walczakkamil/lora_aprs_repeater/img/20260804_183627.jpg

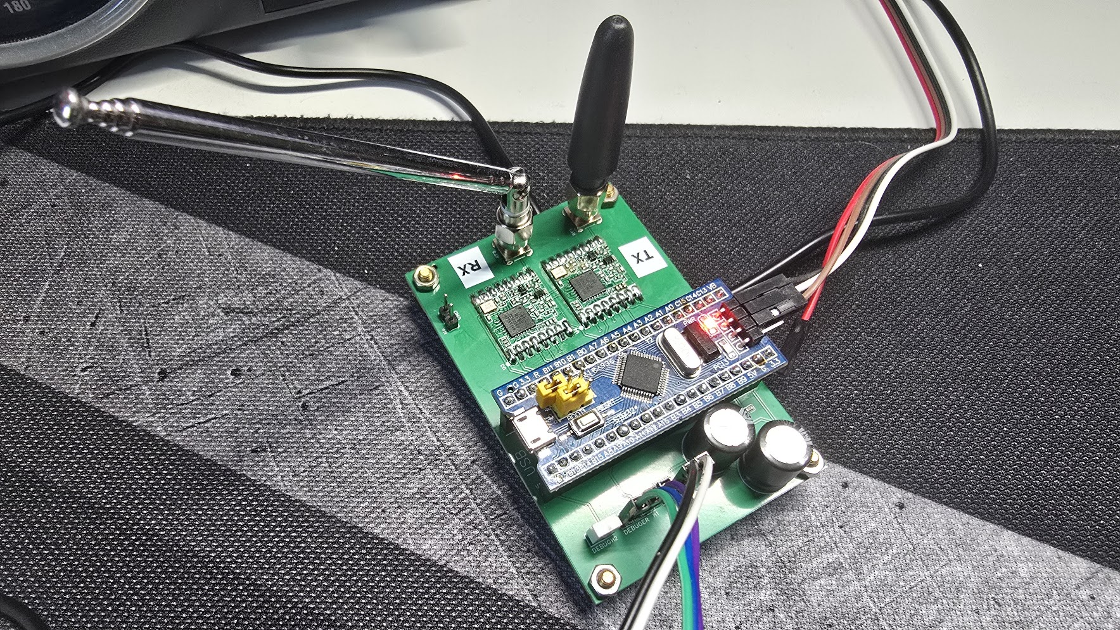
img/20260804_183627.jpg
