walczakkamil/lora_aprs_repeater/(list of files, drawings)

Other design files:
PCB/repeater.eprj
PCB/repeater_v2.eprj
