walczakkamil/lora_aprs_repeater/STM32/Core/Src/main.c

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
/* Includes ------------------------------------------------------------------*/
#include "main.h"

/* USER CODE BEGIN Includes */
#include <stdio.h>
#include <string.h>
#include <stdarg.h>
#include <stdint.h>
/* USER CODE END Includes */

ADC_HandleTypeDef hadc1;

IWDG_HandleTypeDef hiwdg;

RTC_HandleTypeDef hrtc;

SPI_HandleTypeDef hspi1;

UART_HandleTypeDef huart1;

/* USER CODE BEGIN PV */
// --- Hardware configuration ---
// RX Module (RFM96) - SPI1
#define RX_CS_PORT    GPIOA
#define RX_CS_PIN     GPIO_PIN_4
#define RX_RST_PORT   GPIOB
#define RX_RST_PIN    GPIO_PIN_0

// TX Module (RFM96) - SPI1
#define TX_CS_PORT    GPIOA
#define TX_CS_PIN     GPIO_PIN_3
#define TX_RST_PORT   GPIOB
#define TX_RST_PIN    GPIO_PIN_10

// Debug & LED
#define DEBUG_PIN_PORT GPIOB
#define DEBUG_PIN      GPIO_PIN_12
#define LED_PORT       GPIOC
#define LED_PIN        GPIO_PIN_13

// --- LORA Parameters---
#define LORA_RX_FREQ    434855000
#define LORA_TX_FREQ    434955000

#define LORA_RX_SF      9
#define LORA_RX_BW_IDX  7         		// 125 kHz (7 = 125 kHz)
#define LORA_RX_CR      3         		// 4/7
#define LORA_RX_POWER   17        		// Full power (17 dBm)
//#define LORA_RX_POWER   20       		// +20 dBm (100 mW) - High Power PA_DAC

#define LORA_TX_SF      9
#define LORA_TX_BW_IDX  7         		// 125 kHz (7 = 125 kHz)
#define LORA_TX_CR      3         		// 4/7
#define LORA_TX_POWER   10        		// ~50% of power (~10 dBm)

#define TELEMETRY_INTERVAL 3600000 		// 1h
#define APRS_CALLSIGN   "SP7FM-1"
#define APRS_COORDS     "!5144.22N/01934.44E"

// --- SYSTEM ---
#define QUEUE_SIZE 5
#define MAX_PKT_LEN 256

typedef struct {
    uint8_t data[MAX_PKT_LEN];
    uint8_t len;
    uint8_t tx_counter;
} LoRaPacket;

uint16_t tx_reset_counter = 0;
uint32_t lastRebootTick = 0; 	// last restart/start time
uint8_t reset_time = 6;     	// how often reboot, in h

LoRaPacket txQueue[QUEUE_SIZE];
uint8_t queueHead = 0;
uint8_t queueTail = 0;

uint32_t lastTelemetryTime = 0;
volatile uint8_t packetReceivedFlag = 0;
volatile uint8_t txPacketReceivedFlag = 0;

typedef struct {
    GPIO_TypeDef* CS_Port;
    uint16_t      CS_Pin;
    GPIO_TypeDef* RST_Port;
    uint16_t      RST_Pin;
    uint32_t      Frequency;
    uint8_t       SpreadingFactor;
    uint8_t       BandwidthIdx;
    uint8_t       CodingRate;
    uint8_t       Power;
} LoRa_Module;

LoRa_Module loraRX = { RX_CS_PORT, RX_CS_PIN, RX_RST_PORT, RX_RST_PIN, LORA_RX_FREQ, LORA_RX_SF, LORA_RX_BW_IDX, LORA_RX_CR, LORA_RX_POWER };
LoRa_Module loraTX = { TX_CS_PORT, TX_CS_PIN, TX_RST_PORT, TX_RST_PIN, LORA_TX_FREQ, LORA_TX_SF, LORA_TX_BW_IDX, LORA_TX_CR, LORA_TX_POWER };

/* USER CODE END PV */

void SystemClock_Config(void);
static void MX_GPIO_Init(void);
static void MX_SPI1_Init(void);
static void MX_USART1_UART_Init(void);
static void MX_ADC1_Init(void);
static void MX_IWDG_Init(void);
static void MX_RTC_Init(void);
/* USER CODE BEGIN PFP */
void LoRa_Init(LoRa_Module* mod);
void LoRa_SetMode(LoRa_Module* mod, uint8_t mode);
uint8_t LoRa_Send(LoRa_Module* mod, uint8_t* data, uint8_t len);
uint8_t LoRa_Receive(LoRa_Module* mod, uint8_t* buffer);
void Queue_Push(uint8_t* data, uint8_t len, uint8_t tx_counter);
int Queue_Pop(uint8_t* buffer, uint8_t* out_tx_counter);
void SendTelemetry(void);
void DebugPrint(const char *format, ...);
float GetInternalVoltage(void);
/* USER CODE END PFP */

/* USER CODE BEGIN 0 */

// SX1278 registry
#define REG_FIFO 0x00
#define REG_OP_MODE 0x01
#define REG_FRF_MSB 0x06
#define REG_FRF_MID 0x07
#define REG_FRF_LSB 0x08
#define REG_PA_CONFIG 0x09
#define REG_LNA 0x0C
#define REG_FIFO_ADDR_PTR 0x0D
#define REG_FIFO_TX_BASE_ADDR 0x0E
#define REG_FIFO_RX_BASE_ADDR 0x0F
#define REG_FIFO_RX_CURRENT_ADDR 0x10
#define REG_IRQ_FLAGS 0x12
#define REG_RX_NB_BYTES 0x13
#define REG_MODEM_CONFIG_1 0x1D
#define REG_MODEM_CONFIG_2 0x1E
#define REG_DIO_MAPPING_1 0x40

// Operating mode
#define MODE_LONG_RANGE_MODE 0x80
#define MODE_SLEEP 0x00
#define MODE_STDBY 0x01
#define MODE_TX 0x03
#define MODE_RX_CONTINUOUS 0x05

uint8_t LoRa_ReadReg(LoRa_Module* mod, uint8_t addr) {
    uint8_t txByte = addr & 0x7F;
    uint8_t rxByte = 0;
    HAL_GPIO_WritePin(mod->CS_Port, mod->CS_Pin, GPIO_PIN_RESET);
    HAL_SPI_Transmit(&hspi1, &txByte, 1, 100);
    HAL_SPI_Receive(&hspi1, &rxByte, 1, 100);
    HAL_GPIO_WritePin(mod->CS_Port, mod->CS_Pin, GPIO_PIN_SET);
    return rxByte;
}

void LoRa_WriteReg(LoRa_Module* mod, uint8_t addr, uint8_t val) {
    uint8_t data[2] = { addr | 0x80, val };
    HAL_GPIO_WritePin(mod->CS_Port, mod->CS_Pin, GPIO_PIN_RESET);
    HAL_SPI_Transmit(&hspi1, data, 2, 100);
    HAL_GPIO_WritePin(mod->CS_Port, mod->CS_Pin, GPIO_PIN_SET);
}

void LoRa_Init(LoRa_Module* mod) {
    // 0. Check if CS is high before start
    HAL_GPIO_WritePin(mod->CS_Port, mod->CS_Pin, GPIO_PIN_SET);

    // 1. Hardware Reset
    HAL_GPIO_WritePin(mod->RST_Port, mod->RST_Pin, GPIO_PIN_RESET);
    HAL_Delay(15);
    HAL_GPIO_WritePin(mod->RST_Port, mod->RST_Pin, GPIO_PIN_SET);
    HAL_Delay(15);

    // 2. Sleep mode, enable LongRangeMode registry
    LoRa_SetMode(mod, MODE_SLEEP);
    LoRa_WriteReg(mod, REG_OP_MODE, MODE_LONG_RANGE_MODE | MODE_SLEEP);
    HAL_Delay(5);

    // 3. frequency configuration (FRF)
    uint64_t frf = ((uint64_t)mod->Frequency << 19) / 32000000;
    LoRa_WriteReg(mod, REG_FRF_MSB, (uint8_t)(frf >> 16));
    LoRa_WriteReg(mod, REG_FRF_MID, (uint8_t)(frf >> 8));
    LoRa_WriteReg(mod, REG_FRF_LSB, (uint8_t)(frf >> 0));

    // 4. Modem config (BW, CR, SF)
    uint8_t config1 = (mod->BandwidthIdx << 4) | (mod->CodingRate << 1);
    LoRa_WriteReg(mod, REG_MODEM_CONFIG_1, config1);

    // SF, CRC ON (0x04)
    LoRa_WriteReg(mod, REG_MODEM_CONFIG_2, (mod->SpreadingFactor << 4) | 0x04);

    // 5.Power and gain config (LNA)
    // Set LNA Gain (Max gain, Boost on) and PA_CONFIG i OCP for both modules,
    // to enable 2-way communication (RX and TX).
    LoRa_WriteReg(mod, REG_LNA, 0x23);
    if (mod->Power >= 20) {
        // High Power +20 dBm (100 mW)
        LoRa_WriteReg(mod, 0x0B, 0x3B);          // OCP set to 150 mA (wymagane przy +20 dBm)
        LoRa_WriteReg(mod, 0x4D, 0x87);          // RegPaDac: Enable +20 dBm mode
        LoRa_WriteReg(mod, REG_PA_CONFIG, 0x8F); // PA_BOOST pin, max output power (15 + 5 dBm = 20 dBm)
    } else {
        // Standard mode (+2 dBm to +17 dBm)
        LoRa_WriteReg(mod, 0x0B, 0x2B);          // OCP set to 100 mA
        LoRa_WriteReg(mod, 0x4D, 0x84);          // RegPaDac: Normal/Default mode

        uint8_t paPower = (mod->Power < 2) ? 0 : (mod->Power - 2);
        LoRa_WriteReg(mod, REG_PA_CONFIG, 0x80 | paPower);
    }

    // 6. FIFO config
    LoRa_WriteReg(mod, REG_FIFO_TX_BASE_ADDR, 0);
    LoRa_WriteReg(mod, REG_FIFO_RX_BASE_ADDR, 0);

    // 7. Standby mode
    LoRa_SetMode(mod, MODE_STDBY);
    HAL_Delay(5);

    uint8_t ver = LoRa_ReadReg(mod, 0x42);
    DebugPrint("LORA: Init CS Pin %d (Ver: 0x%02X)\r\n", mod->CS_Pin, ver);
}

void LoRa_SetMode(LoRa_Module* mod, uint8_t mode) {
    LoRa_WriteReg(mod, REG_OP_MODE, MODE_LONG_RANGE_MODE | mode);
}

uint8_t LoRa_Send(LoRa_Module* mod, uint8_t* data, uint8_t len) {
    // 1. Wake radio from SLEEP to STDBY
    LoRa_SetMode(mod, MODE_STDBY);

    // !!! IMPORTANT: We allow time for the oscillator to stabilize (Warm-up).
    // Without this, writing to the FIFO may fail immediately after waking up.
    HAL_Delay(2);

    // 2. fill the buffer
    LoRa_WriteReg(mod, REG_FIFO_ADDR_PTR, 0);
    for(int i=0; i<len; i++) {
        LoRa_WriteReg(mod, REG_FIFO, data[i]);
    }

    // 3. start transmitting
    LoRa_WriteReg(mod, 0x22, len);
    LoRa_SetMode(mod, MODE_TX);

    // 4. Wait for TX finish
    uint32_t start = HAL_GetTick();
    uint8_t tx_success = 0;

    while(HAL_GetTick() - start < 2000) { // Timeout 2 sec.
    	if(LoRa_ReadReg(mod, REG_IRQ_FLAGS) & 0x08) {
    		tx_success = 1; // TxDone!
    		break;
		}
	}

    // 5. Clear flags
    LoRa_WriteReg(mod, REG_IRQ_FLAGS, 0xFF);

    // 6. Change mode STDBY to SLEEP, energy savings
    LoRa_SetMode(mod, MODE_SLEEP);

    return tx_success;
}

uint8_t LoRa_Receive(LoRa_Module* mod, uint8_t* buffer) {
    uint8_t irq = LoRa_ReadReg(mod, REG_IRQ_FLAGS);
    if(irq & 0x40) { // RxDone
        uint8_t len = 0;
        if(!(irq & 0x20)) { // CRC OK
            len = LoRa_ReadReg(mod, REG_RX_NB_BYTES);
            uint8_t currentAddr = LoRa_ReadReg(mod, REG_FIFO_RX_CURRENT_ADDR);
            LoRa_WriteReg(mod, REG_FIFO_ADDR_PTR, currentAddr);
            for(int i=0; i<len; i++) {
                buffer[i] = LoRa_ReadReg(mod, REG_FIFO);
            }
        }
        LoRa_WriteReg(mod, REG_IRQ_FLAGS, 0xFF);
        return len;
    }
    return 0;
}

void DebugPrint(const char *format, ...) {
    // Debug mode, PB12
    if(HAL_GPIO_ReadPin(DEBUG_PIN_PORT, DEBUG_PIN) == GPIO_PIN_RESET) {
        char buffer[128];
        va_list args;
        va_start(args, format);
        vsnprintf(buffer, sizeof(buffer), format, args);
        va_end(args);
        HAL_UART_Transmit(&huart1, (uint8_t*)buffer, strlen(buffer), 100);
    }
}

void Queue_Push(uint8_t* data, uint8_t len, uint8_t tx_counter) {
    uint8_t nextHead = (queueHead + 1) % QUEUE_SIZE;
    if(nextHead != queueTail) {
        memcpy(txQueue[queueHead].data, data, len);
        txQueue[queueHead].len = len;
        txQueue[queueHead].tx_counter = tx_counter;
        queueHead = nextHead;
        DebugPrint("QUEUE: Package added (%d B)\r\n", len);
    } else {
        DebugPrint("QUEUE: FULL!\r\n");
    }
}

int Queue_Pop(uint8_t* buffer, uint8_t* out_tx_counter) {
    if(queueHead == queueTail) return 0;

    int len = txQueue[queueTail].len;
    memcpy(buffer, txQueue[queueTail].data, len);

    if(out_tx_counter != NULL) {
        *out_tx_counter = txQueue[queueTail].tx_counter;
    }

    queueTail = (queueTail + 1) % QUEUE_SIZE;
    return len;
}

float GetInternalVoltage(void) {
    HAL_ADC_Start(&hadc1);
    if (HAL_ADC_PollForConversion(&hadc1, 100) == HAL_OK) {
        uint32_t adcVal = HAL_ADC_GetValue(&hadc1);
        if(adcVal == 0) return 0.0;
        // VREFINT usually is 1.20V
        return (1.20f * 4095.0f) / (float)adcVal;
    }
    return 0.0;
}

void SendTelemetry(void) {
    char packet[200];
    float voltage = GetInternalVoltage();

    // LoRa APRS frame format:
    // 1. Head LoRa: < (0x3C), 0xFF, 0x01
    // 2. Head AX.25: Źródło>Cel,Ścieżka:
    // 3. APRS Data: !Lat/Lon#Comment
    // 4. TX reset counter
    sprintf(packet, "\x3c\xff\x01%s>APRS,WIDE1-1:%s#%s BAT:%.2fV R_CNT:%u", APRS_CALLSIGN, APRS_COORDS, APRS_CALLSIGN, voltage, tx_reset_counter);

    DebugPrint("TELEMETRY: %s\r\n", packet + 3); // +3 for better output codding
    Queue_Push((uint8_t*)packet, strlen(packet), 1);
}

// Interruption EXTI (RX DIO0 - PB1 and TX DIO0 - PB11)
void HAL_GPIO_EXTI_Callback(uint16_t GPIO_Pin) {
    if(GPIO_Pin == LORA_DIO0_Pin) {
        packetReceivedFlag = 1;
    } else if(GPIO_Pin == TX_DIO0_Pin) {
        txPacketReceivedFlag = 1;
    }
}

// Check if radio is alvie
uint8_t LoRa_IsAlive(LoRa_Module* mod) {
    // Testing version registry, expected value 0x12 for SX127x
    uint8_t version = LoRa_ReadReg(mod, 0x42);
    uint8_t mode = LoRa_ReadReg(mod, 0x01);

    if (version == 0x12 && mode != 0xFF) {
        return 1; // Radio is alive
    }
    return 0; // Radio not responding or SPI bus hang
}

void Update_Reset_Counter(void) {
    // 1. PWR and registry BKP up
    __HAL_RCC_PWR_CLK_ENABLE();
    __HAL_RCC_BKP_CLK_ENABLE();
    HAL_PWR_EnableBkUpAccess();

    // 2. Read 1st registry
    tx_reset_counter = HAL_RTCEx_BKUPRead(&hrtc, RTC_BKP_DR1);

    // 3. If reset by Watchdoga (IWDG), increment counter
    if (__HAL_RCC_GET_FLAG(RCC_FLAG_IWDGRST)) {
        tx_reset_counter++;
        HAL_RTCEx_BKUPWrite(&hrtc, RTC_BKP_DR1, tx_reset_counter);
    }

    // 4. Reset flags
    __HAL_RCC_CLEAR_RESET_FLAGS();
}

/* USER CODE END 0 */

/**
  * @brief  The application entry point.
  * @retval int
  */
int main(void)
{

  /* MCU Configuration--------------------------------------------------------*/

  /* Reset of all peripherals, Initializes the Flash interface and the Systick. */
  HAL_Init();

  /* Configure the system clock */
  SystemClock_Config();

  /* Initialize all configured peripherals */
  MX_GPIO_Init();
  MX_SPI1_Init();
  MX_USART1_UART_Init();
  MX_ADC1_Init();
  MX_IWDG_Init();
  MX_RTC_Init();
  /* USER CODE BEGIN 2 */

  DebugPrint("SYS: Booting...\r\n");

  // Init RX (434.855 MHz)
  LoRa_Init(&loraRX);
  // Map DIO0 for RxDone (00)
  LoRa_WriteReg(&loraRX, REG_DIO_MAPPING_1, 0x00);
  LoRa_SetMode(&loraRX, MODE_RX_CONTINUOUS);
  DebugPrint("SYS: RX Init OK\r\n");

  // Init TX (434.955 MHz)
  LoRa_Init(&loraTX);
  LoRa_SetMode(&loraTX, MODE_SLEEP);
  DebugPrint("SYS: TX Init OK (Sleeping)\r\n");

  // Start led blinking
  // LED ON (PC13 Low), delay, LED OFF (PC13 High)
  HAL_GPIO_WritePin(LED_PORT, LED_PIN, GPIO_PIN_RESET);
  HAL_Delay(500);
  HAL_GPIO_WritePin(LED_PORT, LED_PIN, GPIO_PIN_SET);

  // Send 1st telemetry
  SendTelemetry();
  lastTelemetryTime = HAL_GetTick();

  /* USER CODE END 2 */

  /* Infinite loop */
  /* USER CODE BEGIN WHILE */
  while (1)
  {
	  // 1 - Testy wstępne

	  // A. Planing reset base on 'reset_time' in hours
	  if ((reset_time != 0) && (HAL_GetTick() - lastRebootTick > (reset_time * 60 * 60 * 1000))) {
	      DebugPrint("SYS: Scheduled %d hour reboot...\r\n", reset_time);
	      HAL_Delay(100);
	      NVIC_SystemReset();
	  }

	  // B. Check radios (IsAlive)
	  uint8_t rxLive = (LoRa_ReadReg(&loraRX, 0x42) == 0x12);
	  uint8_t txLive = (LoRa_ReadReg(&loraTX, 0x42) == 0x12);

	  if (rxLive && txLive) {
	      // Both radios are working - (Watchdog 4s)
	      HAL_IWDG_Refresh(&hiwdg);
	  }
	  else {
	      // Something is wrong, trying reset
	      if (!txLive) {
	          tx_reset_counter++;
	          HAL_RTCEx_BKUPWrite(&hrtc, RTC_BKP_DR1, tx_reset_counter);
	          DebugPrint("SYS: TX hang detected! Resetting TX radio...\r\n");

	          HAL_GPIO_WritePin(TX_RST_PORT, TX_RST_PIN, GPIO_PIN_RESET);
	          HAL_Delay(15);
	          HAL_GPIO_WritePin(TX_RST_PORT, TX_RST_PIN, GPIO_PIN_SET);
	          HAL_Delay(15);

	          LoRa_Init(&loraTX);
	          LoRa_SetMode(&loraTX, MODE_SLEEP);
	      }

	      if (!rxLive) {
	          uint8_t rxVal = LoRa_ReadReg(&loraRX, 0x42);
	          DebugPrint("SYS: RX hang detected! (Reg 0x42 = 0x%02X, exp 0x12) Resetting RX radio...\r\n", rxVal);

	          HAL_GPIO_WritePin(RX_RST_PORT, RX_RST_PIN, GPIO_PIN_RESET);
	          HAL_Delay(15);
	          HAL_GPIO_WritePin(RX_RST_PORT, RX_RST_PIN, GPIO_PIN_SET);
	          HAL_Delay(15);

	          LoRa_Init(&loraRX);
	          // RX back to listen
	          LoRa_SetMode(&loraRX, 0x05); // MODE_RX_CONTINUOUS
	      }

	      // Last chance: if radio is still not working let watchdog know, prevent to reset MCU
	      if ((LoRa_ReadReg(&loraRX, 0x42) == 0x12) && (LoRa_ReadReg(&loraTX, 0x42) == 0x12)) {
	          HAL_IWDG_Refresh(&hiwdg);
	          DebugPrint("SYS: Radios recovered. System continues.\r\n");
	      }
	  }
	  /* --- End security section --- */

	// 2. Reciving
    if(packetReceivedFlag) {
		packetReceivedFlag = 0;
		uint8_t rxBuffer[MAX_PKT_LEN];
		uint8_t len = LoRa_Receive(&loraRX, rxBuffer);

		if(len > 0) {
			DebugPrint("RX: Recv %d bytes\r\n", len);

			// --- DEBUG ---
			// check debug pin
			if(HAL_GPIO_ReadPin(DEBUG_PIN_PORT, DEBUG_PIN) == GPIO_PIN_RESET) {

				// 1. Show as a text
				char debugMsg[MAX_PKT_LEN + 1];
				int safeLen = (len < MAX_PKT_LEN) ? len : MAX_PKT_LEN;
				memcpy(debugMsg, rxBuffer, safeLen);
				debugMsg[safeLen] = '\0';
				DebugPrint("RX CONTENT (TXT): %s\r\n", debugMsg);

				// 2. show as a HEX
				char hexBuf[10];
				DebugPrint("RX HEX: ");
				for(int i=0; i<safeLen; i++) {
					sprintf(hexBuf, "%02X ", rxBuffer[i]);
					HAL_UART_Transmit(&huart1, (uint8_t*)hexBuf, strlen(hexBuf), 10);
				}
				DebugPrint("\r\n");
			}

            // new package in queue to send
			Queue_Push(rxBuffer, len, 1);
		}

		// Restart RX Continuous
		LoRa_SetMode(&loraRX, MODE_RX_CONTINUOUS);
	}

    // 3. Transmitting
    if(queueHead != queueTail) {
		uint8_t txBuffer[MAX_PKT_LEN];
		uint8_t msg_tx_counter = 1;
		int len = Queue_Pop(txBuffer, &msg_tx_counter);

		if(len > 0) {
			DebugPrint("TX: Preparing to send...\r\n");
			DebugPrint("TX msg. counter: %d\r\n", msg_tx_counter);

			// pin check
			if(HAL_GPIO_ReadPin(DEBUG_PIN_PORT, DEBUG_PIN) == GPIO_PIN_RESET) {
				char debugMsg[MAX_PKT_LEN + 1]; // +1 for last string character

				// Overfill protection
				int safeLen = (len < MAX_PKT_LEN) ? len : MAX_PKT_LEN;

				memcpy(debugMsg, txBuffer, safeLen);
				debugMsg[safeLen] = '\0';

				DebugPrint("APRS CONTENT: %s\r\n", debugMsg);
			}
			// -----------------------------------------------

			// LED ON (PC13 Low)
			HAL_GPIO_WritePin(LED_PORT, LED_PIN, GPIO_PIN_RESET);

			//LoRa_Send(&loraTX, txBuffer, len);
			if (LoRa_Send(&loraTX, txBuffer, len)) {
			    DebugPrint("TX: Success\r\n");

			    // --- Read answer on TX, 10 sec. ---
			    DebugPrint("TX_RX: Switching TX module to RX mode for 10s response window...\r\n");

			    // Prepare TX for receiving: STDBY -> Reset FIFO ptr -> Clear IRQ -> RX_CONTINUOUS
			    LoRa_SetMode(&loraTX, MODE_STDBY);
			    HAL_Delay(2);
			    LoRa_WriteReg(&loraTX, REG_FIFO_ADDR_PTR, 0);
			    LoRa_WriteReg(&loraTX, REG_DIO_MAPPING_1, 0x00); // Map DIO0 on RxDone (00)
			    LoRa_WriteReg(&loraTX, REG_IRQ_FLAGS, 0xFF); // reset old flags
			    txPacketReceivedFlag = 0;
			    LoRa_SetMode(&loraTX, MODE_RX_CONTINUOUS);

			    uint32_t waitStart = HAL_GetTick();
			    uint8_t txReplyReceived = 0;

			    while (HAL_GetTick() - waitStart < 10000) {
			        HAL_IWDG_Refresh(&hiwdg); // refresh watchdog

			        // 1. Check RX for new messages
			        if (packetReceivedFlag) {
			            packetReceivedFlag = 0;
			            uint8_t rxBuf[MAX_PKT_LEN];
			            uint8_t rxLen = LoRa_Receive(&loraRX, rxBuf);
			            if (rxLen > 0) {
			                DebugPrint("RX (during TX_RX wait): Recv %d bytes, queuing...\r\n", rxLen);
			                Queue_Push(rxBuf, rxLen, 1);
			            }
			            LoRa_SetMode(&loraRX, MODE_RX_CONTINUOUS);
			        }

			        // 2. Check for message on TX (interrupt on EXTI15_10 - PB11)
			        uint8_t replyBuffer[MAX_PKT_LEN];
			        uint8_t replyLen = 0;

			        if (txPacketReceivedFlag) {
			            txPacketReceivedFlag = 0;
			            replyLen = LoRa_Receive(&loraTX, replyBuffer);
			        } else {
			            // direct pooling if interruption is not working
			            replyLen = LoRa_Receive(&loraTX, replyBuffer);
			        }

			        if (replyLen > 0) {
			            DebugPrint("TX_RX: Reply received on TX module (%d B)\r\n", replyLen);

			            if (HAL_GPIO_ReadPin(DEBUG_PIN_PORT, DEBUG_PIN) == GPIO_PIN_RESET) {
			                char debugMsg[MAX_PKT_LEN + 1];
			                int safeLen = (replyLen < MAX_PKT_LEN) ? replyLen : MAX_PKT_LEN;
			                memcpy(debugMsg, replyBuffer, safeLen);
			                debugMsg[safeLen] = '\0';
			                DebugPrint("TX_RX REPLY CONTENT: %s\r\n", debugMsg);
			            }

			            // Retransmitting answer on RX
			            DebugPrint("TX_RX: Retransmitting reply via RX module...\r\n");
			            LoRa_Send(&loraRX, replyBuffer, replyLen);
			            LoRa_SetMode(&loraRX, MODE_RX_CONTINUOUS);

			            txReplyReceived = 1;
			            break;
			        }

			        HAL_Delay(5);
			    }

			    if (!txReplyReceived) {
			        DebugPrint("TX_RX: 10s wait window ended, no reply received.\r\n");
			    }

			    // loraTX go sleep
			    LoRa_SetMode(&loraTX, MODE_SLEEP);
			    // -------------------------------------------------------------
			} else {
				if (msg_tx_counter < 3) {
					DebugPrint("TX: FAILED! Re-queuing...\r\n");
					msg_tx_counter++;
					Queue_Push(txBuffer, len, msg_tx_counter);
				} else {
					DebugPrint("TX: FAILED! %d time, forgetting...\r\n", msg_tx_counter);
				}
			}

			// LED OFF (PC13 High)
			HAL_GPIO_WritePin(LED_PORT, LED_PIN, GPIO_PIN_SET);
			DebugPrint("TX: Done.\r\n");
		}
	}

    // 4. Telemetry
    if(HAL_GetTick() - lastTelemetryTime > TELEMETRY_INTERVAL) {
        SendTelemetry();
        lastTelemetryTime = HAL_GetTick();
    }

    // 5. Sleep
    if(queueHead == queueTail && !packetReceivedFlag) {
        // Suspend Tick to avoid waking up every 1ms, but the LoRa EXTI will wake up the MCU.
        // Note: The IWDG is independent, so the MCU will still reset if it sleeps too long.
        // IWDG Reload is set to ~4 seconds, so we need to wake up more often.
        // It's safer not to use SuspendTick on the IWDG without careful calculation.
        // We use regular WFI - SysTick (1ms) or LoRa EXTI wakes us up.
        HAL_PWR_EnterSLEEPMode(PWR_MAINREGULATOR_ON, PWR_SLEEPENTRY_WFI);
    }

    /* USER CODE END WHILE */

    /* USER CODE BEGIN 3 */
  }
  /* USER CODE END 3 */
}

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
