walczakkamil/lora_aprs_repeater/STM32/Lora_APRS_repeater.ioc

Mcu.UserName=STM32F103C8Tx
PA10.Signal=USART1_RX
PA3.GPIO_Label=TX_CS
PA3.Signal=GPIO_Output
PA4.GPIO_Label=LORA_CS
PA4.Signal=GPIO_Output
PA5.GPIO_Label=LORA_SCK
PA5.Signal=SPI1_SCK
PA6.GPIO_Label=LORA_MISO
PA6.Signal=SPI1_MISO
PA7.GPIO_Label=LORA_MOSI
PA7.Signal=SPI1_MOSI
PA9.Signal=USART1_TX
PB0.GPIO_Label=LORA_RST
PB0.Signal=GPIO_Output
PB1.GPIO_Label=LORA_DIO0
PB1.Signal=GPXTI1
PB10.GPIO_Label=TX_RST
PB10.Signal=GPIO_Output
PB11.GPIO_Label=TX_DIO0
PB11.Signal=GPXTI11
PB12.Signal=GPIO_Input
PC13-TAMPER-RTC.Signal=GPIO_Output
