walczakkamil/lora_aprs_repeater/(commit log)

2026-07-31 add pcb project
    [repeater.eprj]
2026-08-04 Add more control on output power
2026-08-06 add power consumption to README.md and README_pl.md
2026-09-09 pcb v2
    [repeater_v2.eprj]
